brianbezanson/openlst-hw/(commit log)

2023-09-11 Migrate to KiCad 7 files, schematic visual cleanup, pcb routing cleanup
    [openlst-hw.kicad_pcb, openlst-hw.kicad_sch, openlst-hw.sch]
2023-09-11 DRC cleanup
    [openlst-hw.kicad_pcb]
2023-09-11 Replace stitching pads with vias, add top ground fill
    [openlst-hw.kicad_pcb]
2023-09-12 Adjust SMA pads and board setup
    [openlst-hw.kicad_pcb]
2023-09-13 Silkscreen labels for UART pins
    [openlst-hw.kicad_pcb]
