brianbezanson/openlst-hw/(notices)

Notices in the files:
openlst-hw.kicad_sch:
This work is licensed under a Creative Commons Attribution-ShareAlike 4.0 International
Copyright 2018 Planet Labs Inc
openlst-hw.kicad_pcb:
International License (CC-BY-SA 4.0).
